labdvm/REFLOW-PCB/ReFlow PCB_front.png

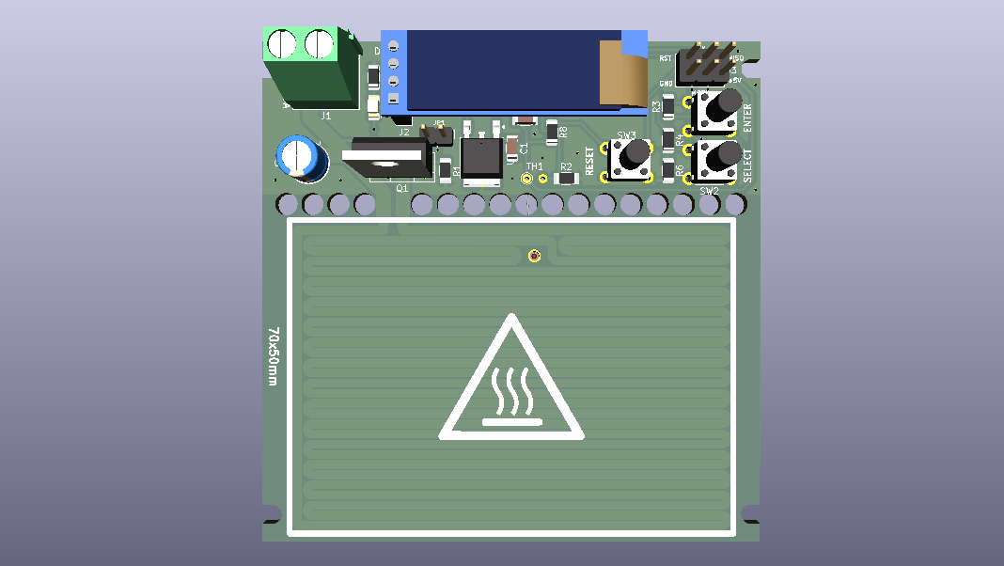
ReFlow PCB_front.png
