labdvm/REFLOW-PCB/ReFlow PCB_back.png

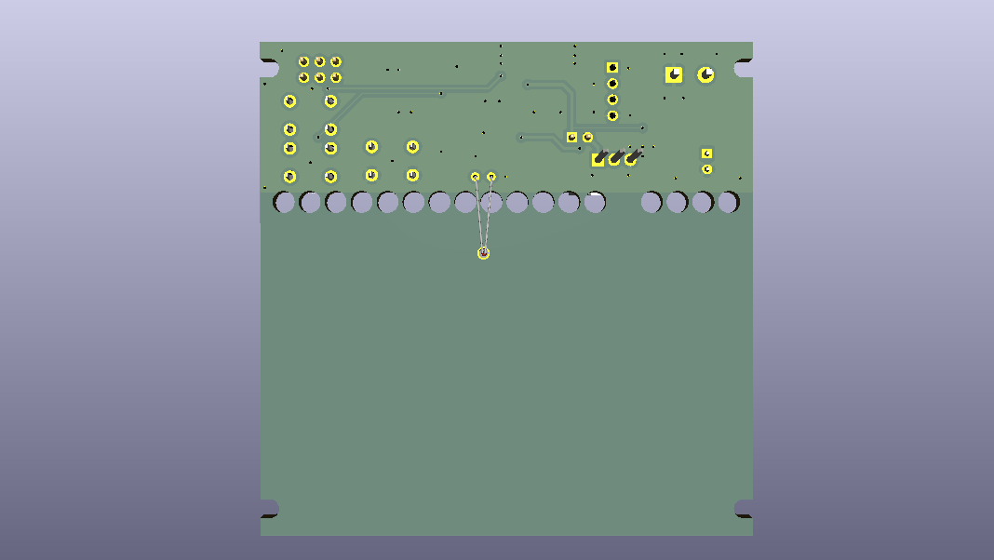
ReFlow PCB_back.png
