labdvm/REFLOW-PCB/README.md

# REFLOW-PCB
ReFlow PCB with ATtyny85
- Modification from " https://github.com/rallekralle11/Tinyreflow "
# J3 programming interface
- 1= +5Vcc
- 2= PB1_MISO
- 3= PB0_MOSI
- 4= PB2_SCK
- 5= GND
- 6= PB5_RST
