labdvm/REFLOW-PCB/OLED.stp

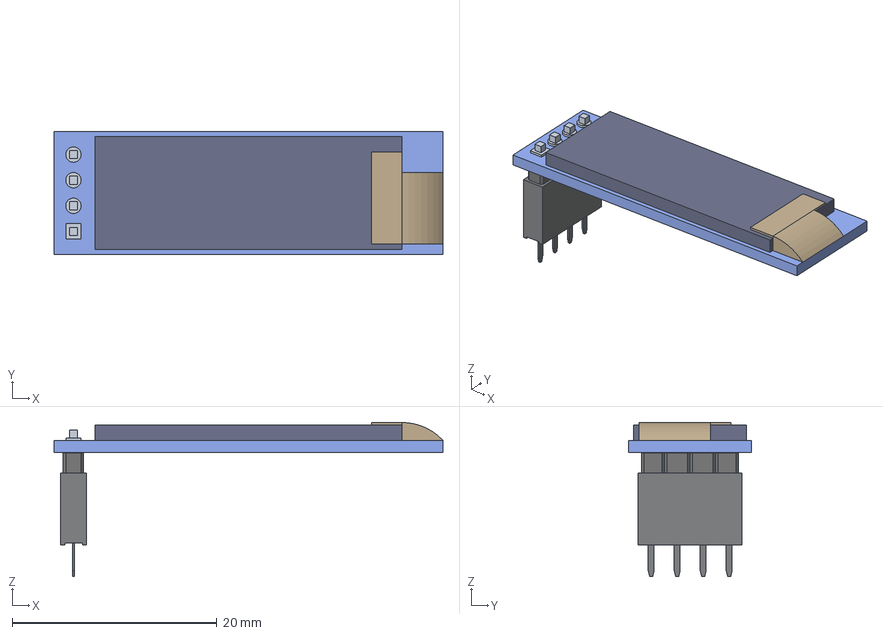
[picture p3: CAD file, 2026-02-17]
OLED.stp
38.0 x 12.0 x 15.1 mm
