labdvm/REFLOW-PCB/weirdthermistor.stp

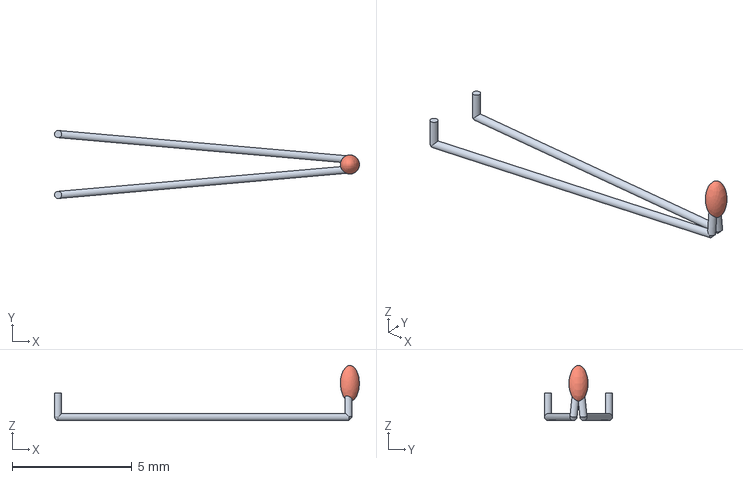
[picture p4: CAD file, 2026-02-17]
weirdthermistor.stp
12.7 x 2.84 x 2.30 mm
