labdvm/REFLOW-PCB/ReFlow PCB.pdf

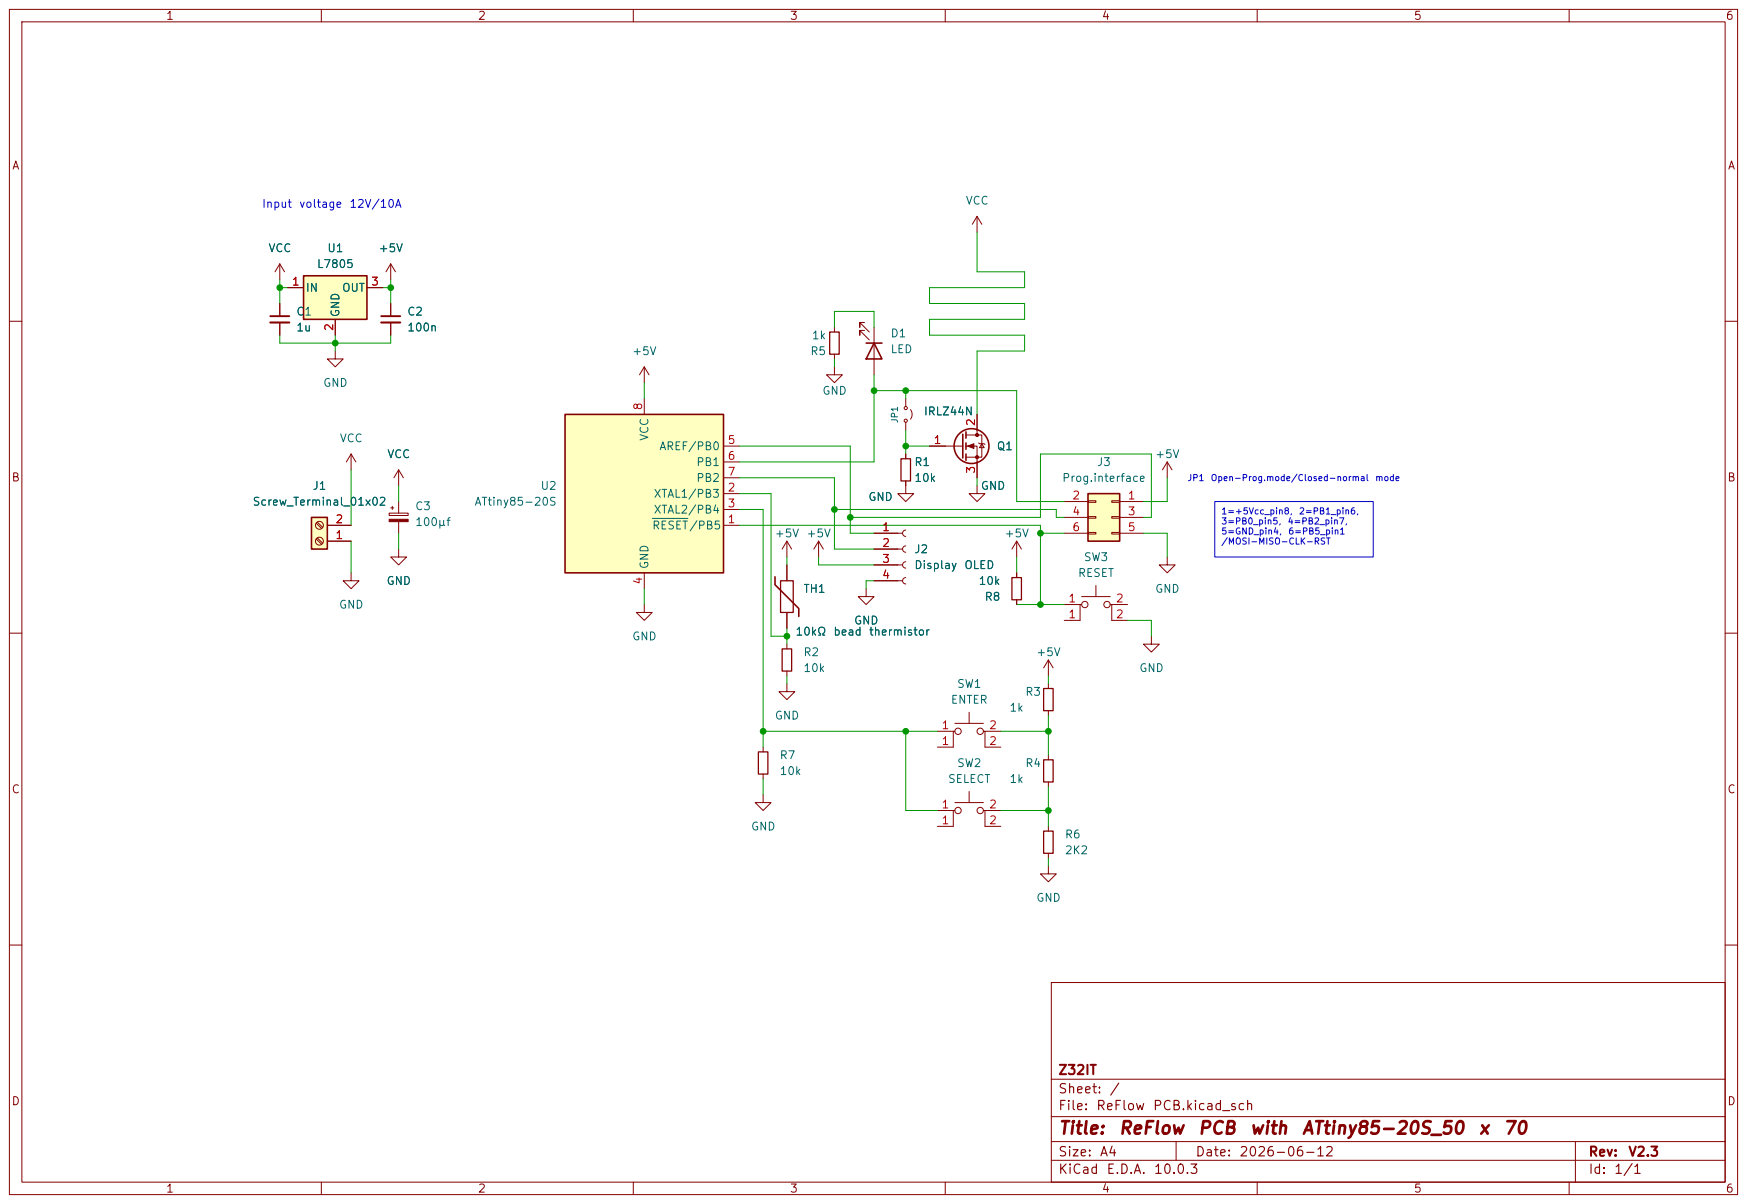
[picture p5: page 1]

JP1 Open-Prog.mode/Closed-normal mode

1=+5Vcc_pin8, 2=PB1_pin6, 3=PB0_pin5, 4=PB2_pin7, 5=GND_pin4, 6=PB5_pin1 /MOSI-MISO-CLK-RST

Sheet: /
File: ReFlow PCB.kicad_sch
Title: ReFlow PCB with ATtiny85-20S_50 x 70

Size: A4 | Rev: V2.3
KiCad E.D.A. 10.0.3 | Id: 1/1
