labdvm/REFLOW-PCB/ReFlow PCB.kicad_pcb

## KiCad design ReFlow PCB.kicad_pcb (2026-06-12)

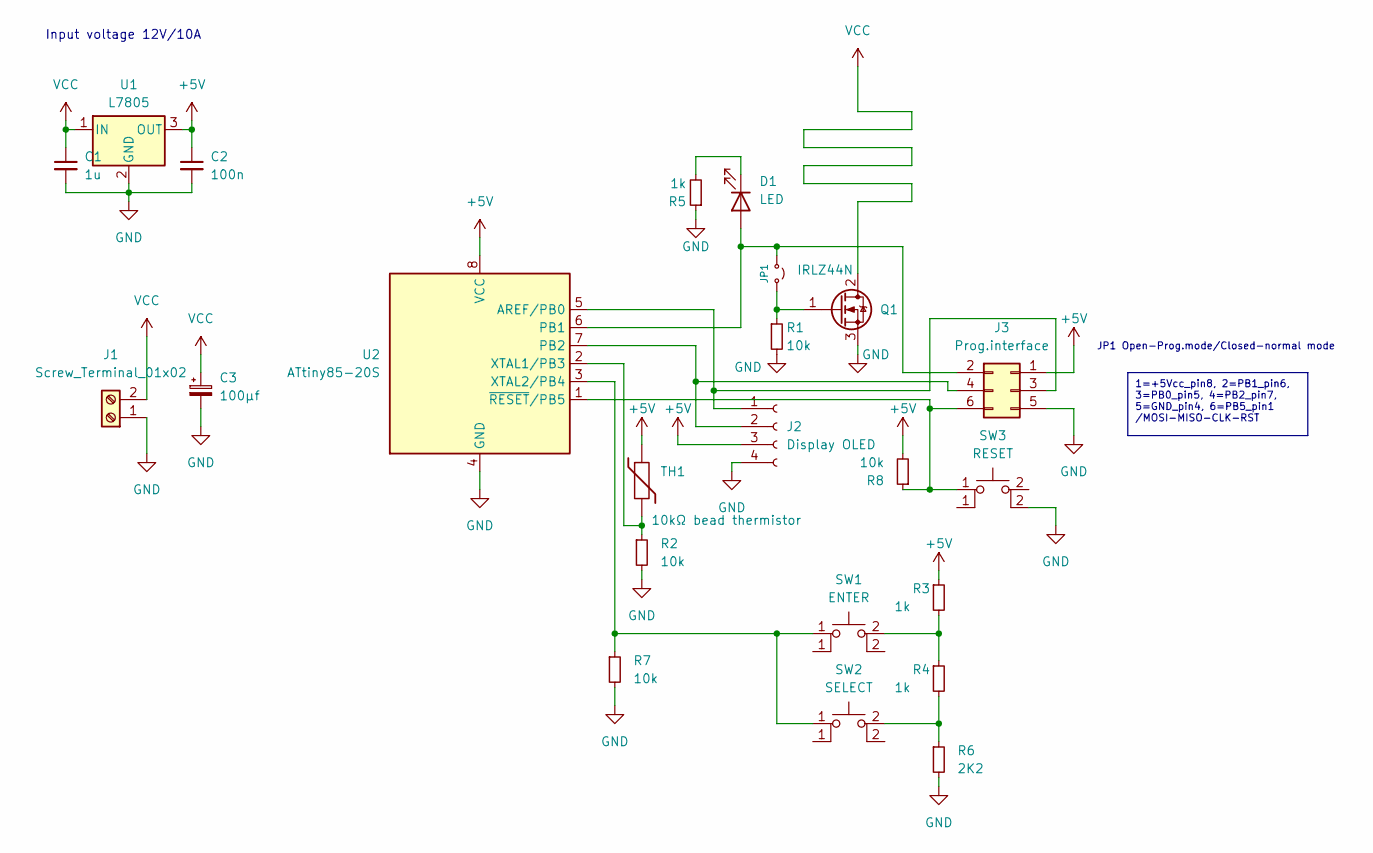
[picture p6: schematic ReFlow PCB.kicad_sch, ReFlow PCB with ATtiny85-20S_50 x 70]

Parts:
C1: 1u; C_1206_3216Metric
C2: 100n; C_1206_3216Metric
C3: 100µf; CP_Radial_D6.3mm_P2.50mm
D1: LED; LED_1206_3216Metric
J1: Screw_Terminal_01x02; TerminalBlock_Phoenix_MKDS-1,5-2-5.08_1x02_P5.08mm_Horizont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
J2: Display OLED; PinSocket_1x04_P2.54mm_Vertical
J3: Prog.interface; PinHeader_2x03_P2.54mm_Vertical
JP1: PinHeader_1x02_P2.54mm_Vertical
Q1: IRLZ44N; TO-220-3_Vertical
R1, R2, R7, R8: 10k; R_1206_3216Metric
R3, R4, R5: 1k; R_1206_3216Metric
R6: 2K2; R_1206_3216Metric
SW1: ENTER; SW_PUSH_6mm_H9.5mm
SW2: SELECT; SW_PUSH_6mm_H9.5mm
SW3: RESET; SW_PUSH_6mm_H9.5mm
TH1: 10kΩ bead thermistor; R_Axial_DIN0204_L3.6mm_D1.6mm_P2.54mm_Vertical
U1: L7805; TO-252-2
U2: ATtiny85-20S; SOIC-8_5.3x5.3mm_P1.27mm

Connections:
+5V: C2.1, J2.3, J3.1, R3.1, R8.2, TH1.1, U1.3 (OUT), U2.8 (VCC)
GND: C1.2, C2.2, C3.2, J1.1, J2.4, J3.5, Q1.3 (S), R1.2, R2.2, R5.1, R6.2, R7.2, SW3.2, U1.2 (GND), U2.4 (GND)
unnamed: D1.2 (A), J3.2, JP1.1 (A), U2.6 (PB1)
unnamed: D1.1 (K), R5.2
unnamed: J2.1, J3.3, U2.5 (AREF/PB0)
unnamed: J2.2, J3.4, U2.7 (PB2)
unnamed: J3.6, R8.1, SW3.1, U2.1 (~RESET/PB5)
unnamed: JP1.2 (B), Q1.1 (G), R1.1
unnamed: R3.2, R4.1, SW1.2
unnamed: R4.2, R6.1, SW2.2
unnamed: R2.1, TH1.2, U2.2 (XTAL1/PB3)
unnamed: R7.1, SW1.1, SW2.1, U2.3 (XTAL2/PB4)
VCC: C1.1, C3.1, J1.2, Q1.2 (D), U1.1 (IN)

Notes on the sheet:
Input voltage 12V/10A
JP1 Open-Prog.mode/Closed-normal mode
1=+5Vcc_pin8, 2=PB1_pin6, 3=PB0_pin5, 4=PB2_pin7, 5=GND_pin4, 6=PB5_pin1 /MOSI-MISO-CLK-RST

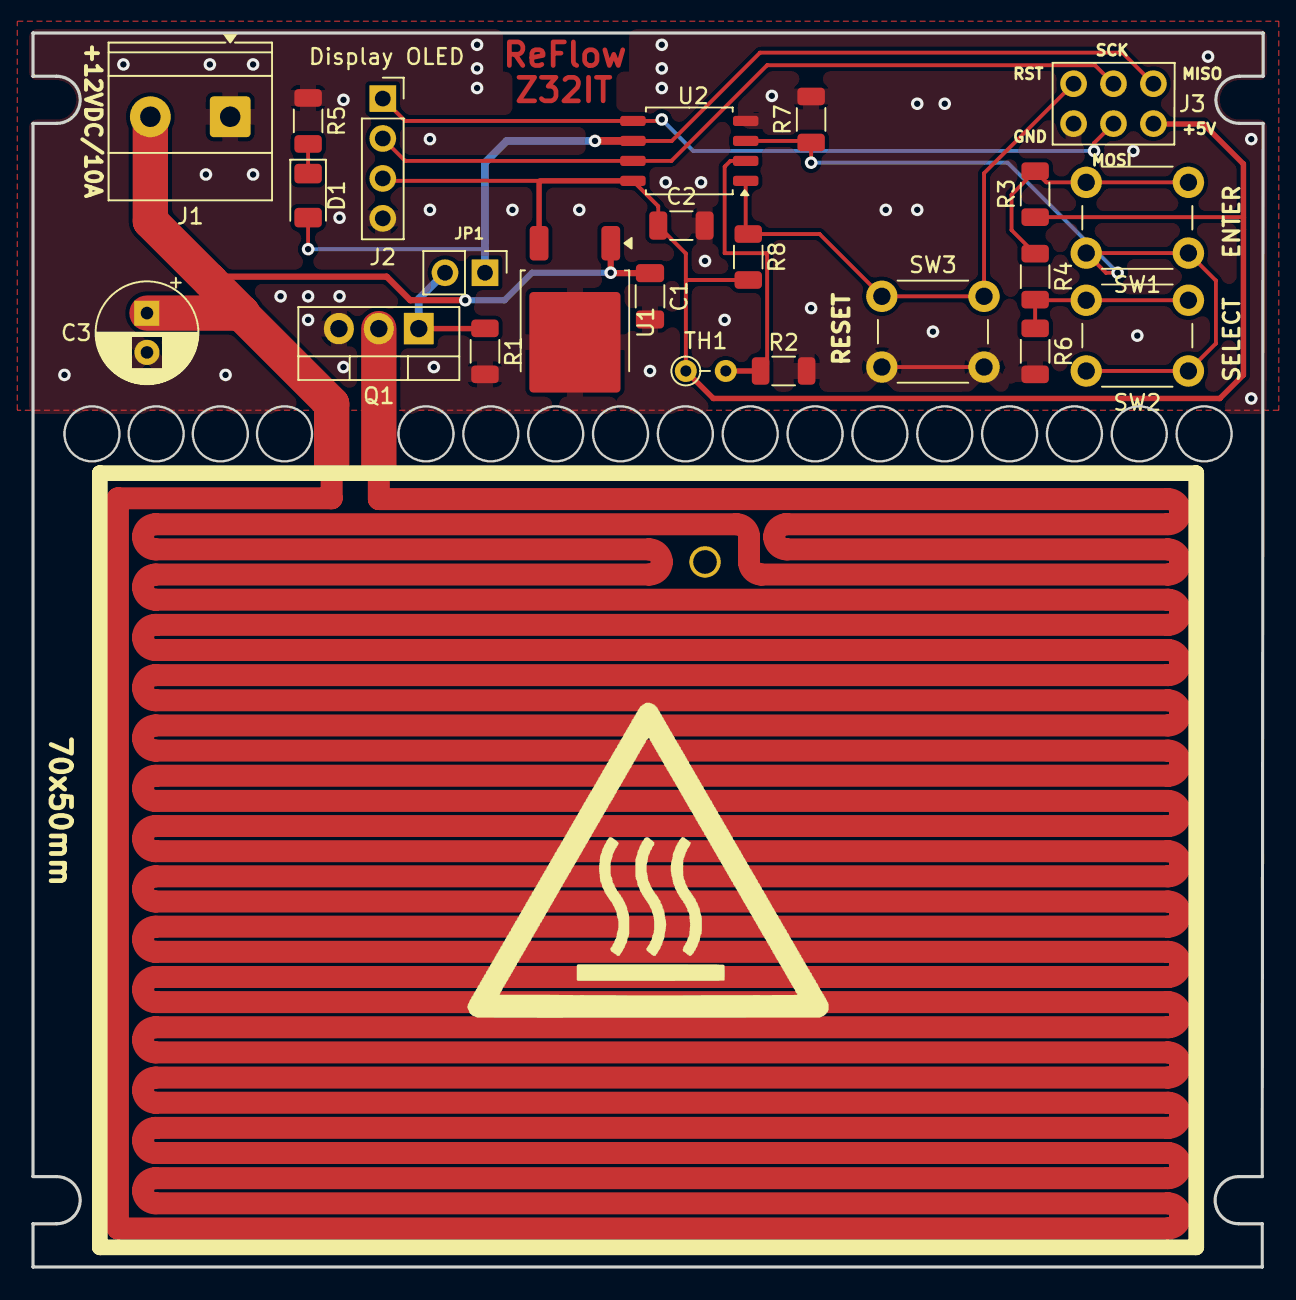
[picture p7: board ReFlow PCB.kicad_pcb from above]

Board: 2 copper layers, 78.2 x 78.5 mm, 23 parts (0 on the bottom side), 13 nets.
